sverrham/heatexchanger/3d-model/tube.FCStd

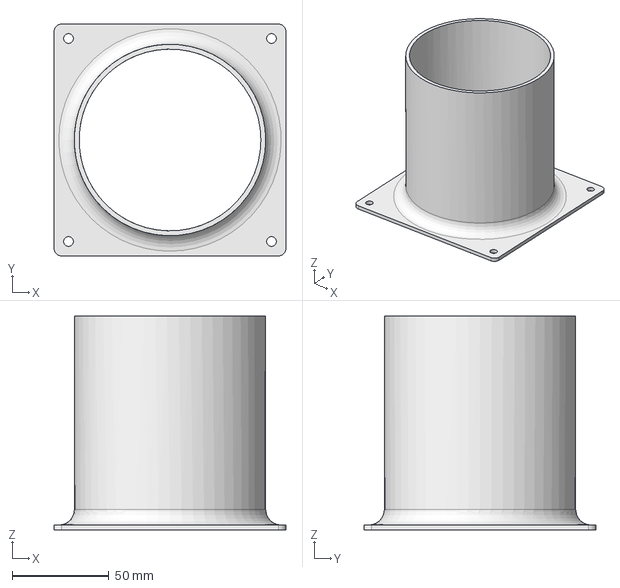
[picture p9: CAD file, 2023-12-22]
3d-model/tube.FCStd
120.0 x 120.0 x 110.5 mm
