sverrham/heatexchanger/(list of files, drawings)

Other design files:
hw/prototype.fzz
