sverrham/heatexchanger/(commit log)

2023-12-11 Initial sw for prototype
2023-12-11 Add bom and prototype hw with fritzing drawing
    [prototype.fzz]
2023-12-22 Add 3d model
    [tube.FCStd]
2023-12-22 Add picture of prototype
2024-04-06 Add sending mqtt data for temp sensors.
2024-04-07 Fixes and tested adding 10k ntc resistor works reading out and calculating temp with this.
    [main.cpp]
